google/nfc-smart-tag/docs/FirmwareStack.png

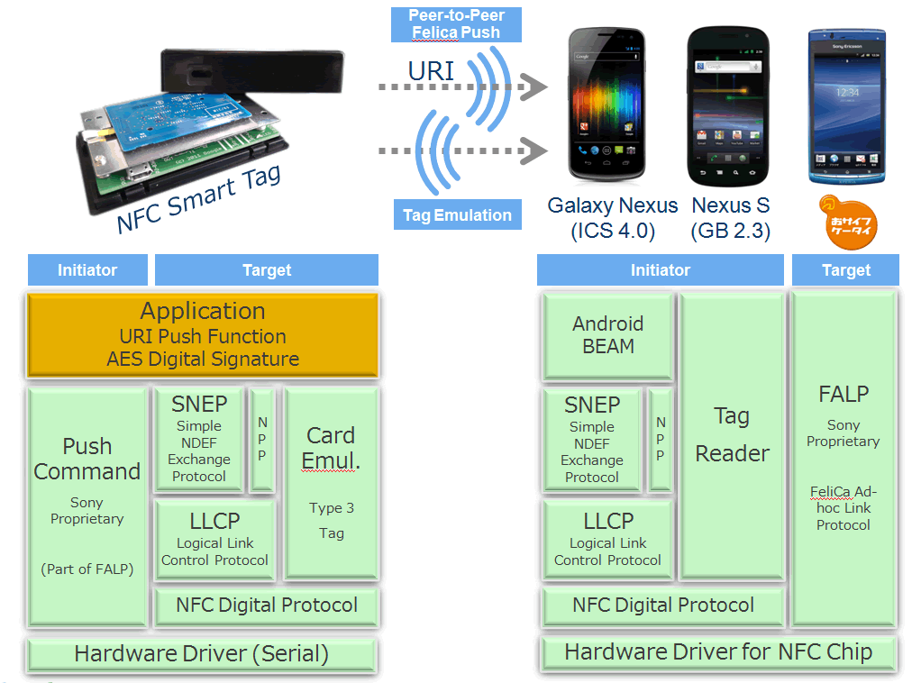
docs/FirmwareStack.png
