google/nfc-smart-tag/docs/lc115n/01_PCB_Front.JPG

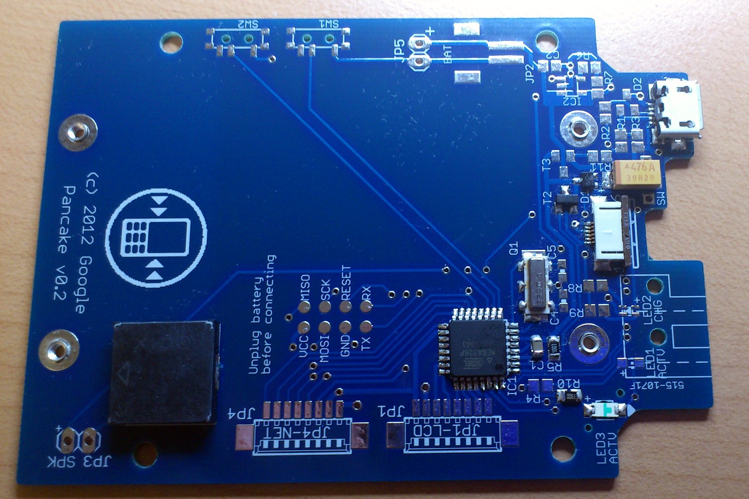
docs/lc115n/01_PCB_Front.JPG
