google/nfc-smart-tag/demoserver/readme.txt

Please download KeyCzar jar file from:
http://code.google.com/p/keyczar/downloads/list

Please download Protobuf source code, and compile it:
http://code.google.com/p/protobuf/downloads/list
