google/nfc-smart-tag/docs/FirmwareModules.png

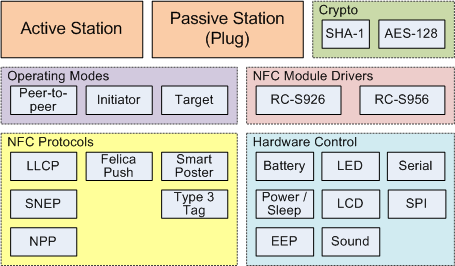
docs/FirmwareModules.png
