google/nfc-smart-tag/docs/lc115n/02_PCB_Back.JPG

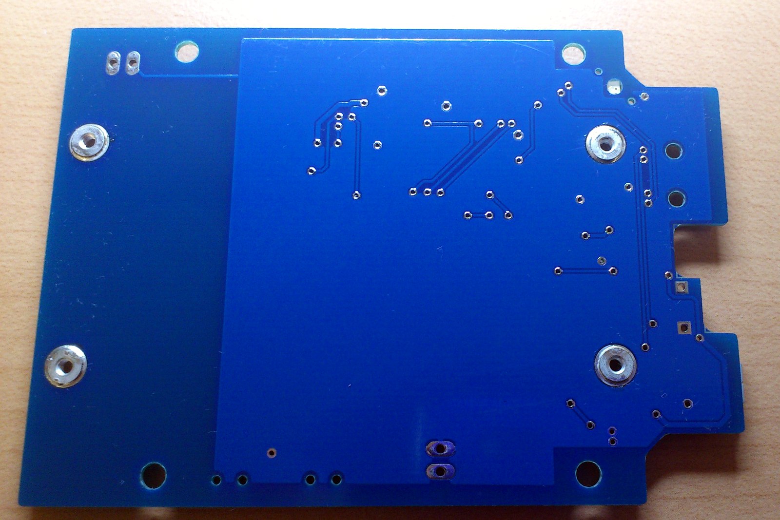
docs/lc115n/02_PCB_Back.JPG
