google/nfc-smart-tag/docs/lc115n/03_Tape.JPG

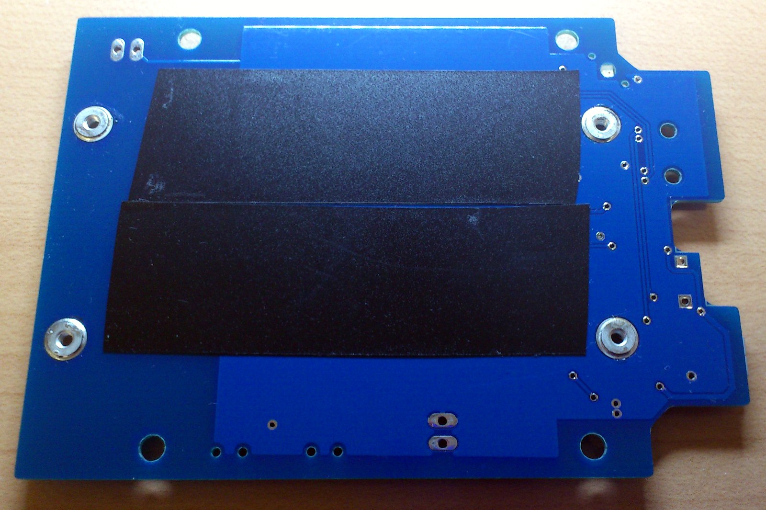
docs/lc115n/03_Tape.JPG
