google/nfc-smart-tag/docs/lc115n/04_RC_S620.JPG

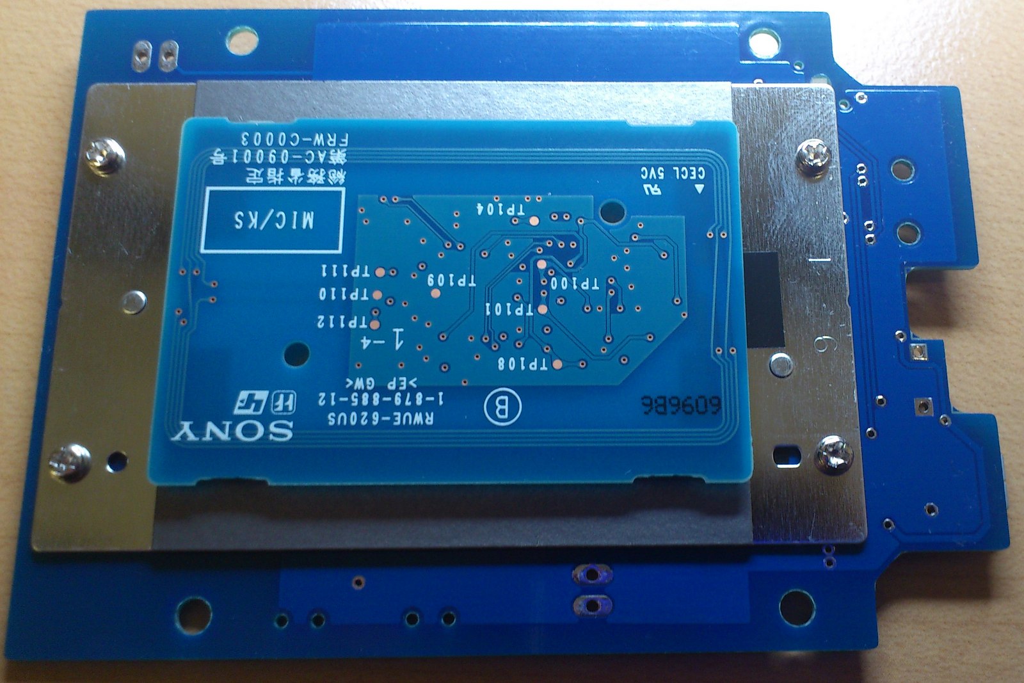
docs/lc115n/04_RC_S620.JPG
