google/nfc-smart-tag/docs/lc115n/05_Cable_Back.JPG

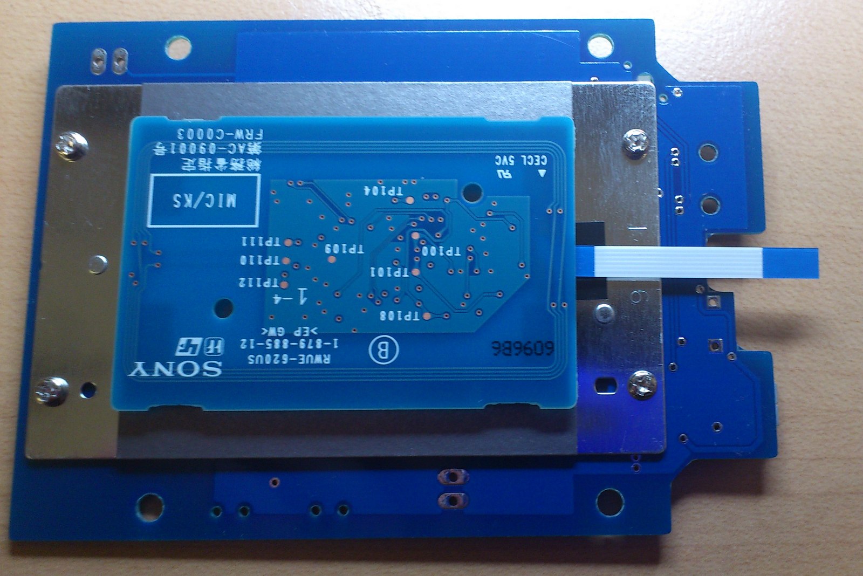
docs/lc115n/05_Cable_Back.JPG
