google/nfc-smart-tag/docs/lc115n/06_Cable_Front.JPG

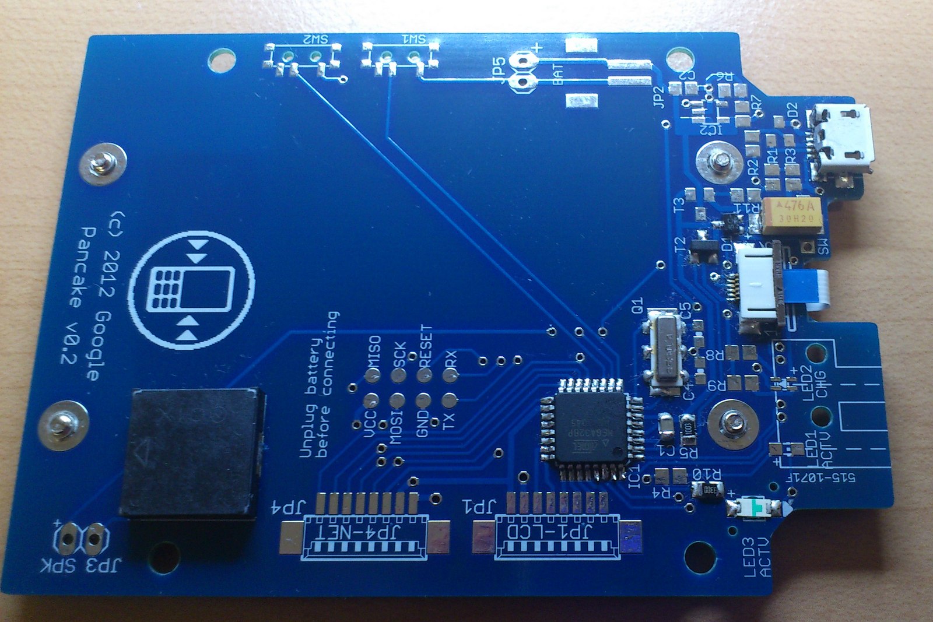
docs/lc115n/06_Cable_Front.JPG
