google/nfc-smart-tag/docs/lc115n/07_Cable_Edge.JPG

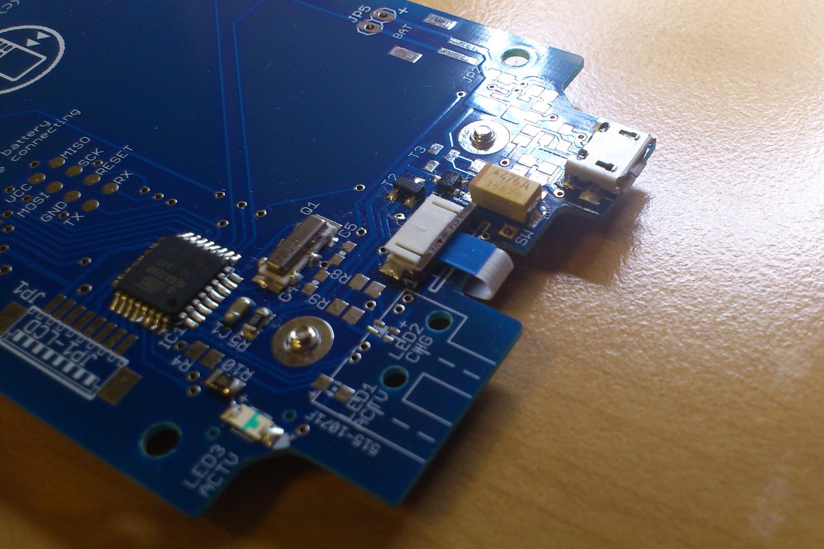
docs/lc115n/07_Cable_Edge.JPG
