google/nfc-smart-tag/docs/lc115n/08_Case_Cover_Inside.JPG

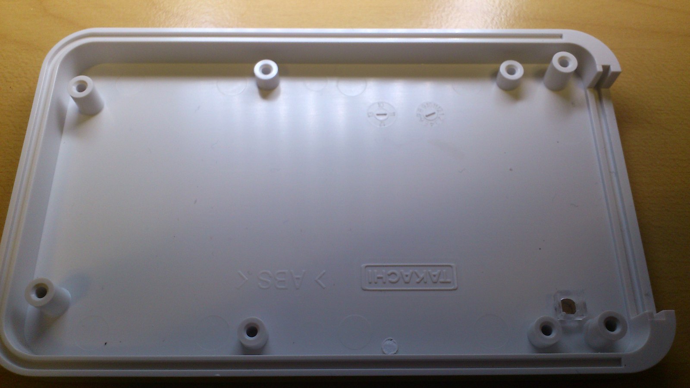
docs/lc115n/08_Case_Cover_Inside.JPG
