google/nfc-smart-tag/docs/lc115n/09_PCB_Case.JPG

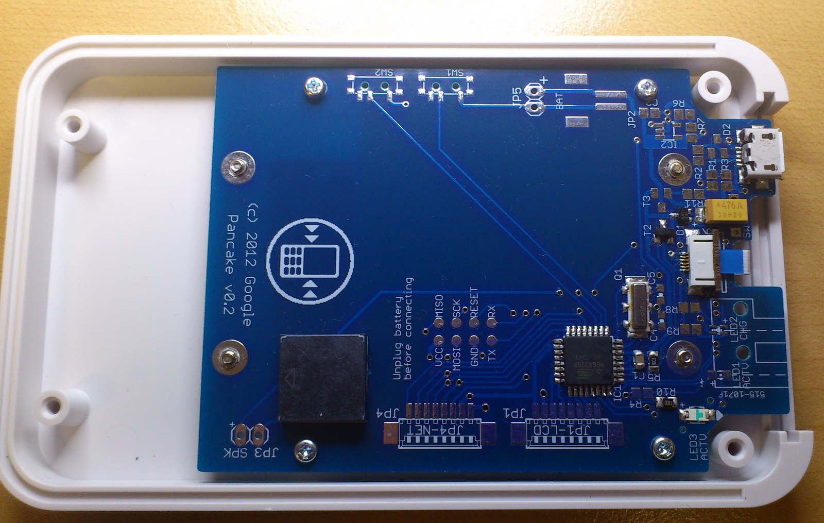
docs/lc115n/09_PCB_Case.JPG
