google/nfc-smart-tag/docs/lc115n/10_Case_Cover_Outside.JPG

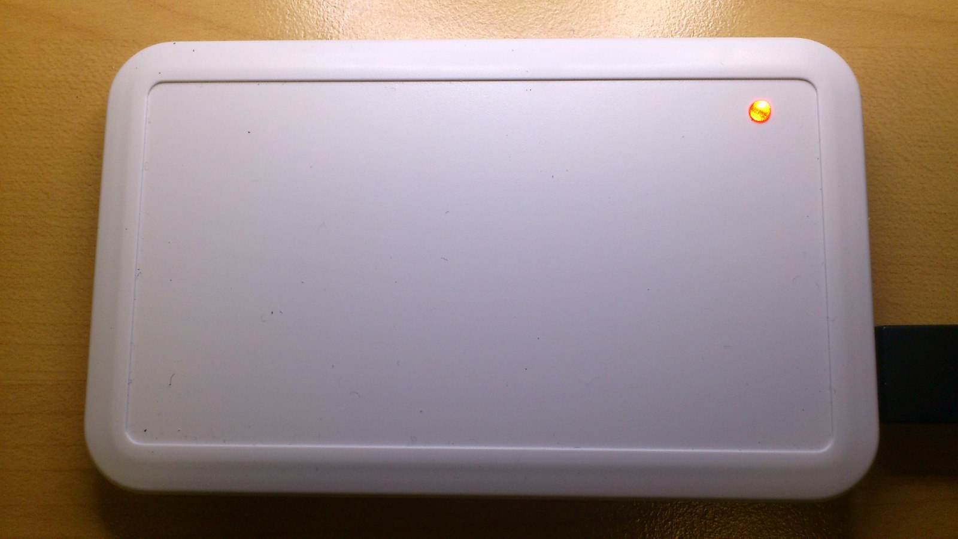
docs/lc115n/10_Case_Cover_Outside.JPG
