google/nfc-smart-tag/docs/lc115n/11_Battery.JPG

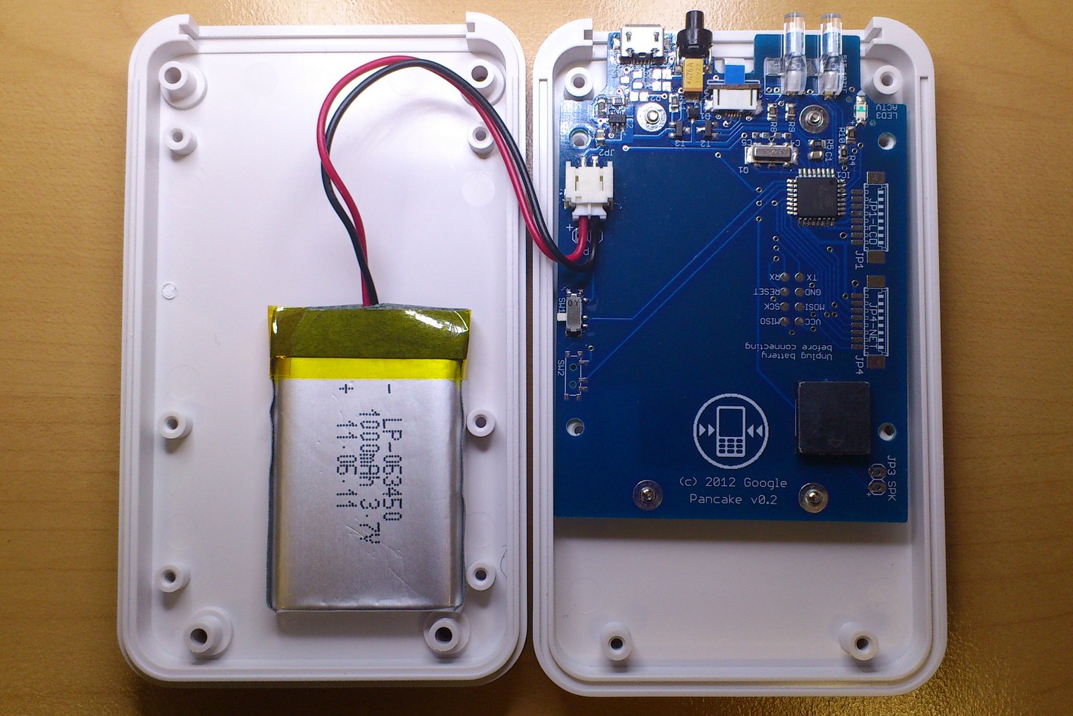
docs/lc115n/11_Battery.JPG
