google/nfc-smart-tag/docs/lc115n/12_Front_Panel_Interior.JPG

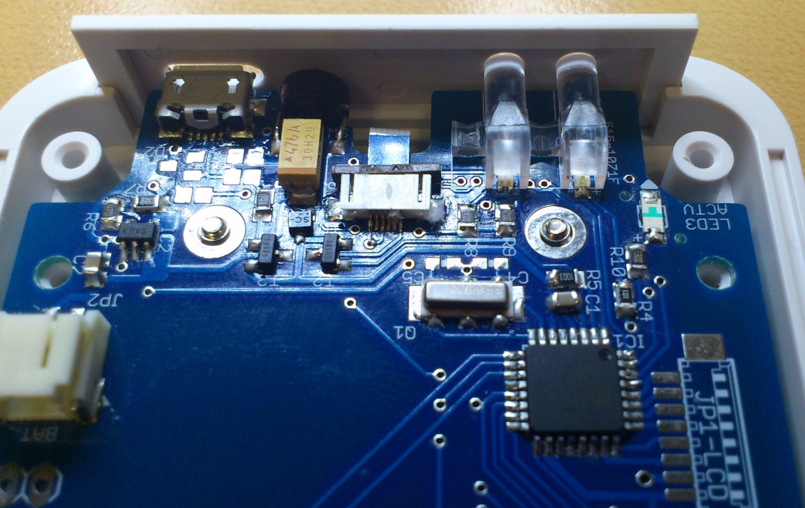
docs/lc115n/12_Front_Panel_Interior.JPG
