google/nfc-smart-tag/docs/lc115n/13_Front_Panel_Exterior.JPG

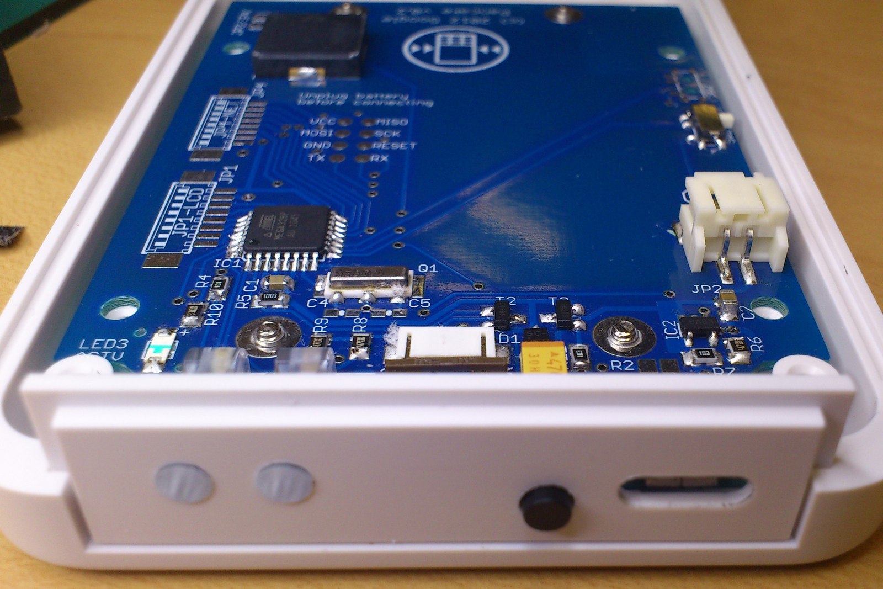
docs/lc115n/13_Front_Panel_Exterior.JPG
