google/nfc-smart-tag/docs/LLCP.png

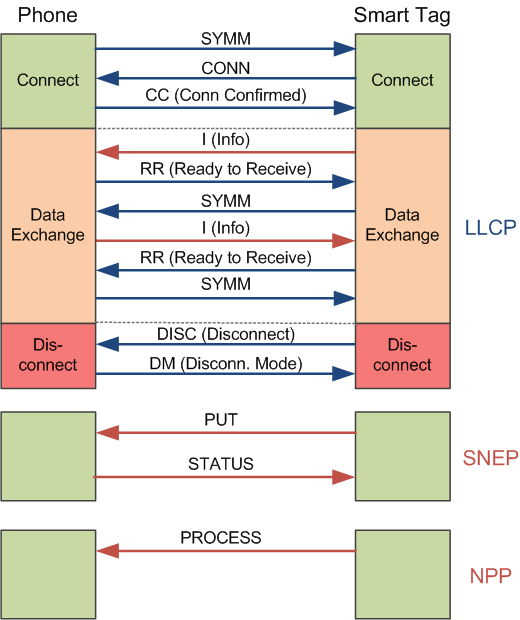
docs/LLCP.png
