google/nfc-smart-tag/docs/NfcUrl2Crypto.png

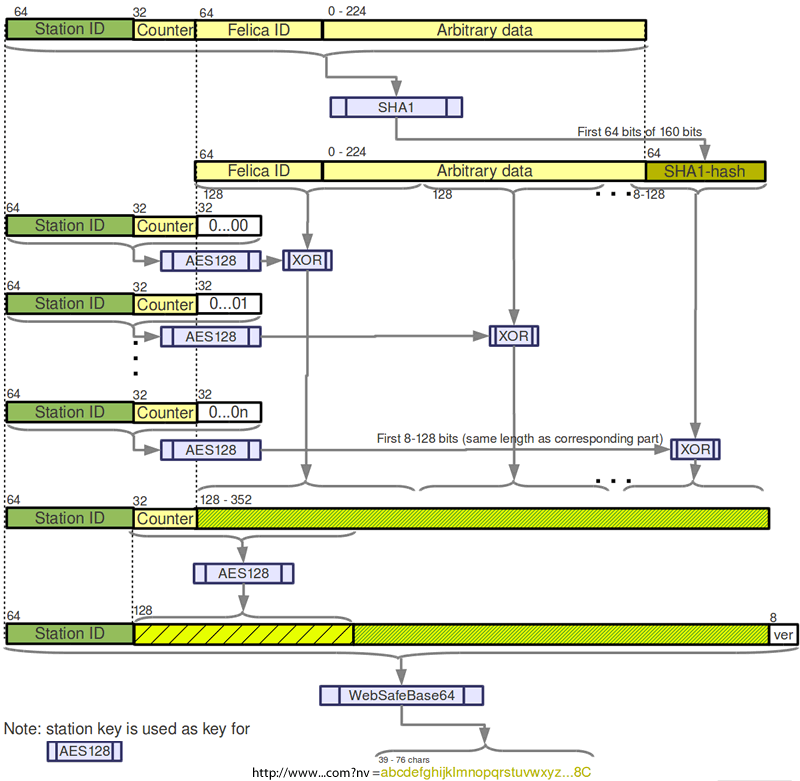
docs/NfcUrl2Crypto.png
