google/nfc-smart-tag/docs/NfcUrl.png

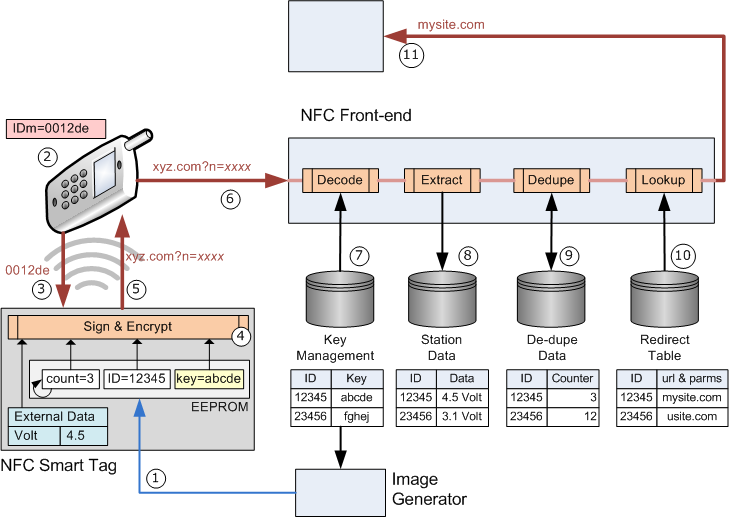
docs/NfcUrl.png
