google/nfc-smart-tag/docs/NfcUrlEncoding.png

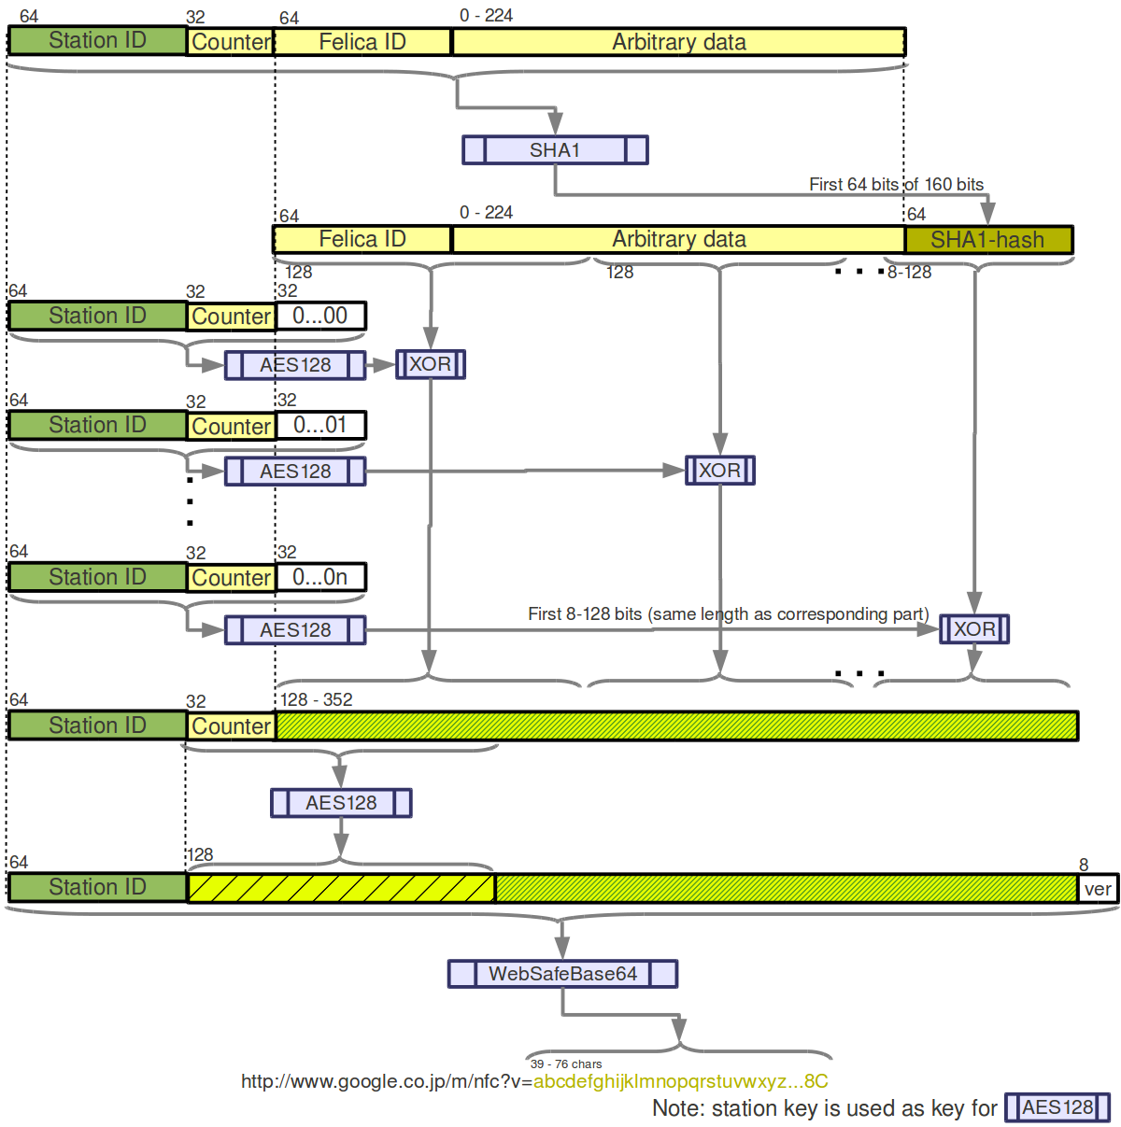
docs/NfcUrlEncoding.png
