google/nfc-smart-tag/hardware/pancake-schematic.png

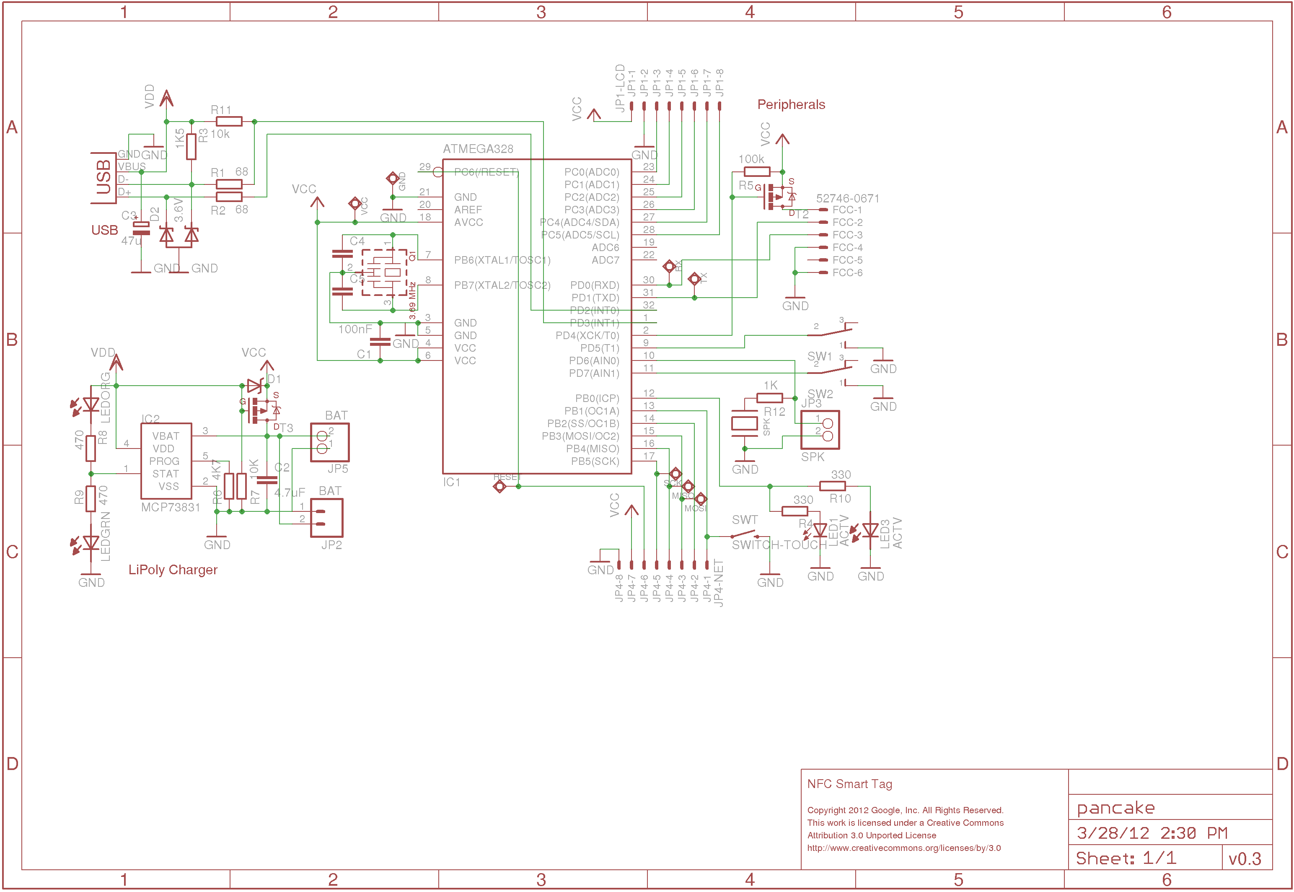
hardware/pancake-schematic.png
