google/nfc-smart-tag/hardware/sandwich-schematic.png

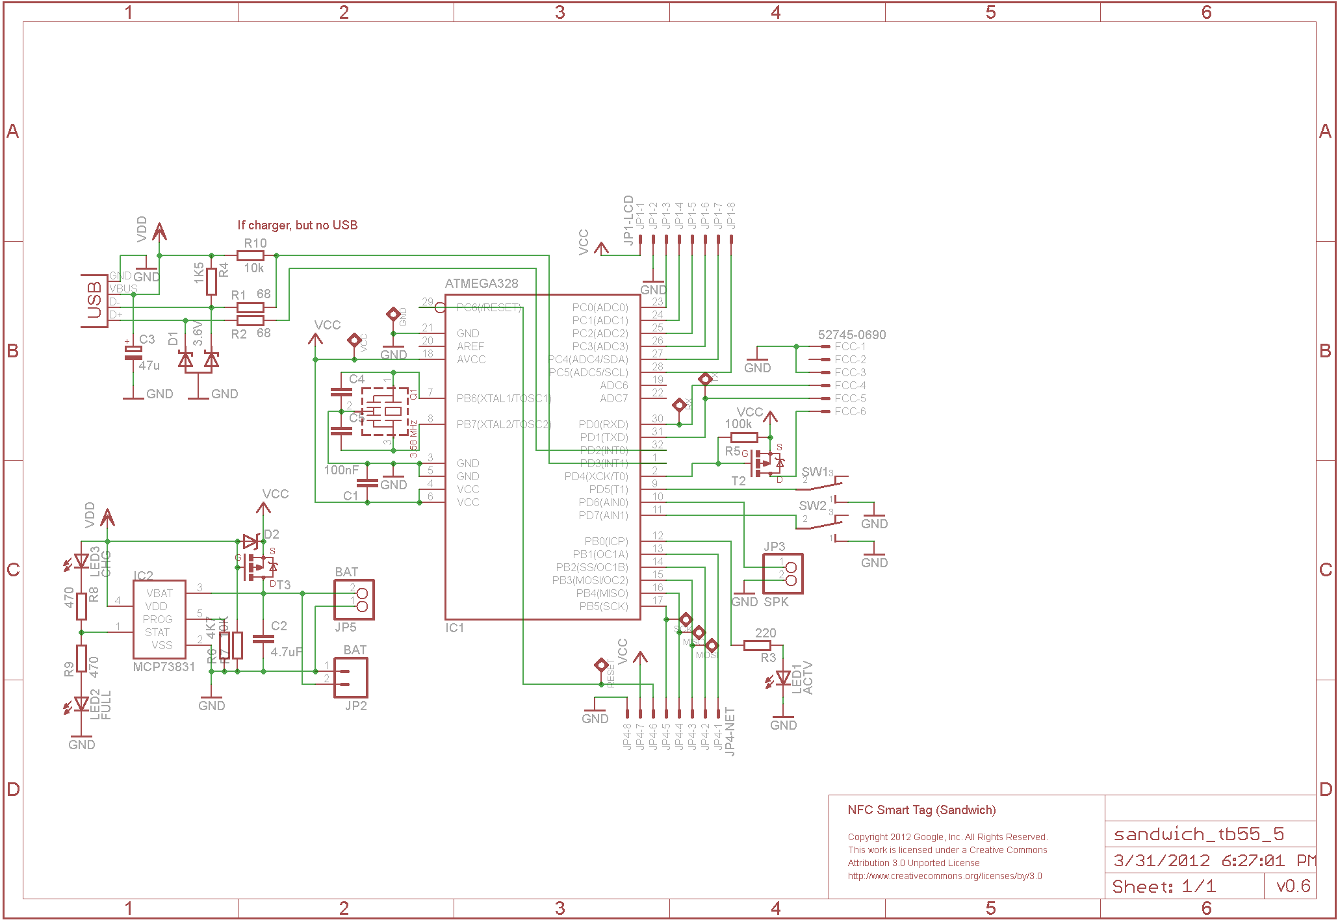
hardware/sandwich-schematic.png
