google/nfc-smart-tag/hardware/NfcSmartTagPartlist.xls

Sheet: Pancake v0.3
Identifier | Quantity | Mfg Part Number | Description | Package | RS Part # | Digikey Part # | Datasheet / Detail
 | 1 | RC-S620/S | Felica R/W Module UART |  |  |  | http://www.sony.co.jp/Products/felica/pdt/rdw9.html
IC1 | 1 | ATMEGA328P-AU | Atmel AVR ATMega 328P | TQFP-32 | 696-3092 | ATMEGA328P-AU-ND | http://akizukidenshi.com/catalog/g/gI-04386/
C1 | 1 | C0805C104K5RAC | Capacitor 0.1 uF | SMD 0805 | 264-4416 | 399-1170-6-ND
Q1 | 1 | CSTCC3M69G53-R0 | Ceramic Oscillator 3.69 MHz 15pF (Murata) | SMD | 624-1005 |  | http://docs-asia.electrocomponents.com/webdocs/0021/0900766b80021b54.pdf
 | 0 | CX8045GB16000H0HEQZ1 | 16.000MHz Quartz | 8.0x4.5mm | 693-6236P |  | http://global.kyocera.com/prdct/electro/pdf/xtal/cx8045gb_cs_e.pdf
C4,C5 | 0 | GRM1885C1H120JA01D | Capacitor 12pF | SMD 0603 | 653-0349 |  | http://jp.rs-online.com/web/p/ceramic-multilayer/6530349/
C3 | 1 | TAJC476K010RNJ | Capacitor 47uF/10V Tantal | SMD 6032 | 464-8000 | 478-3910-1-ND | http://docs-asia.electrocomponents.com/webdocs/0e0c/0900766b80e0c346.pdf
 | 1 | Molex 21020-0051 | FCC Cable 0.5mm pitch 6 pin 30mm |  |  | WM14311-ND | www.molex.com/product/premoflex_ffc-fpc.html
FCC | 1 | Molex 52746-0671 | FCC/FPC Connector 0.5mm pitch 6 pin BOTTOM contact |  | 702-5431 | WM7977CT-ND | http://www.molex.com/molex/products/datasheet.jsp?part=active/0527460671_FFC_FPC_CONNECTORS.xml
USB | 1 | ZX62-B-5PA(11) | Micro USB SMD connector |  | 685-0965 | H11634CT-ND | http://www.hirose.co.jp/cataloge_hp/e24200011.pdf
BATT | 1 | S2B-PH-SM4-TB | JST2 Connector side entry SMT | 2mm | 688-1353 | 455-1749-1-ND | http://www.jst-mfg.com/product/pdf/eng/ePH.pdf
IC2 | 1 | MCP73831T-2ACI/OT | Li Poli Battery charge controller | SOT-23-5 | 669-6137 |  | http://jp.rs-online.com/web/p/battery-management/6696137P/
C2 | 1 | SMT CAP 4.7uF | Capacitor 4.7uF | SMD 0805 | 723-6041
R6 | 1 | CRG0805F4K7 | Charge control resistor 4.7kOhm | SMD 0805 | 223-0528
R7 | 1 | ERJ-6GEYJ103V | Gate pull-down resistor 10kOhm | SMD 0805 |  | P10KACT-ND
LED2 | 1 | SML-521MDWT86 | Dual color LED green / orange | SMD 0605 | 475-2569 | 511-1316-1-ND | http://docs-asia.electrocomponents.com/webdocs/1020/0900766b81020b10.pdf
R8, R9 | 2 | CRG0805F470R | Charge LED Resistor 470Ohm | SMD 0805 | 223-0376
D1 | 1 | AB1003M3-S-TL | Shottky Diode | MCPH-3 | 664-1177 |  | http://docs-asia.electrocomponents.com/webdocs/0d02/0900766b80d023e0.pdf
PIPE1 | 1 | 515-1071F | Dialight Lightpipe Dual 3mm |  | 546-1400 | 350-1590-ND | http://www.dialight.com/Product/Details/445028/5151071F
R11 | 1 | ERJ-6GEYJ103V | Ext. Power sense resistor 10kOhm | SMD 0805 |  | P10KACT-ND
SW | 1 | EVQ-11L07K | Pushbutton 7mm 160gf |  |  | P8080SCT-ND
T2, T3 | 2 | IRLML6402 | P-chan MOSFET 20V 65mOhm | SOT-23 | 301-322 | IRLML6402PBFCT-ND
R5 | 1 | ERJ-6GEYJ104V | Gate pull-down Resistor 100kOhm | SMD 0805 |  | P100KACT-ND
R1, R2 | 2 | CRG0805F68R | Resistor 68Ohm | SMD 0805 | 223-0275 | P68ACT-ND
R3 | 1 | CRG0805F1K5 | Resistor 1.5kOhm | SMD 0805 | 223-0449 | P1.5KACT-ND
D2 | 1 | AZ23C3V6-7-F | Dual Zener Diode 3.6V common anode | SOT 23 | 708-1841 |  | http://docs-asia.electrocomponents.com/webdocs/0e37/0900766b80e37071.pdf
R4 | 1 | ERJ-6GEYJ331V | Resistor 330Ohm 0.125W | SMD 0805 | 434-135 | P330ACT-ND
LED1 | 1 | LTST-C170KRKT | LED red 54mCd ACTV | SMD 0805 | 692-0916 | 160-1415-1-ND | http://docs-asia.electrocomponents.com/webdocs/0dc0/0900766b80dc027b.pdf
R10 |  | ERJ-6GEYJ331V | Resistor 330Ohm 0.125W | SMD 0805 | 434-135 | P330ACT-ND
LED3 | 1 | LTST-C230KFKT | LED Orange 90mCd Reverse | SMD 1206 | 692-1095 | 160-1458-1-ND | http://docs-asia.electrocomponents.com/webdocs/0dc0/0900766b80dc0579.pdf
 | 0 | LTST-C230KGKT | LED Green 35mCd Reverse | SMD 1206 | 692-1105 | 160-1456-1-ND
 | 0 | LTST-C230KRKT | LED Red 54mCd Reverse | SMD 1206 |  | 160-1457-1-ND
PIPE2 | 0 | VLP-250-F | Lightpipe Round 3mm vertical 6mm long (Bivar) |  | 713-4765 | 492-1307-ND | http://docs-asia.electrocomponents.com/webdocs/0e77/0900766b80e77d26.pdf
SPK | 1 | PKLCS1212E2000-R1 | Buzzer Murata | SMT | 619-8456 | 490-5260-1-ND | http://www.murata.com/products/catalog/pdf/p37e.pdf
R12 | 1 | ERJ-6GEYJ102V | Resistor 1kOhm | SMD 0805 | 434-191 | P1.0KATR-ND
JP1, JP4 | 0 | 53261-0871 | Molex Picoblade | SMT | 542-7157 | WM7626CT-ND | http://www.molex.com/customer.html?supplierPN=53261-0871
SW1,SW2 | 2 | CUS-12B | Slide Switch SMT |  | 602-3633 | 563-1102-1-ND | http://docs-asia.electrocomponents.com/webdocs/074f/0900766b8074ff1d.pdf
 | 1 | Takachi LC115-N | Case |  |  |  | http://www.takachi-enclosure.com/data/pdf/English_LCS_LC_0331.pdf
 | 2 | Takachi EM-2.3 | Takachi Case screw |  |  |  | http://www.takachi-el.co.jp/data/bin/price_disp.php?num[]=EM
 | 4 | TH-1.6-M2 | Through Hole Tap |  | MAC8 |  | http://www.mac8sdk.co.jp/mac8/pdf/TH.pdf
 | 4 |  | Screw M2 3mm
 | 1 |  | PCB
 |  |  | Total Cost

Sheet: Sandwich v0.5
Identifier | Quantity | Mfg Part Number | Description | Package | RS Part # | Digikey Part # | Datasheet / Detail
 | 1 | RC-S620/S | Felica R/W Module UART |  |  |  | http://www.sony.co.jp/Products/felica/pdt/rdw9.html
IC1 | 1 | ATMEGA328P-AU | Atmel AVR ATMega 328P | TQFP-32 | 696-3092 | ATMEGA328P-AU-ND | http://akizukidenshi.com/catalog/g/gI-04386/
C1 | 1 | C0805C104K5RAC | Capacitor 0.1 uF | SMD 0805 | 264-4416 | 399-1170-6-ND
Q1 | 1 | CSTCC3M69G53-R0 | Ceramic Oscillator 3.69 MHz 15pF | SMD | 624-1005 |  | http://docs-asia.electrocomponents.com/webdocs/0021/0900766b80021b54.pdf
 | 0 | CX8045GB16000H0HEQZ1 | 16.000MHz Quartz | 8.0x4.5mm | 693-6236P |  | http://global.kyocera.com/prdct/electro/pdf/xtal/cx8045gb_cs_e.pdf
C4,C5 | 0 | GRM1885C1H120JA01D | Capacitor 12pF | SMD 0603 | 653-0349 |  | http://jp.rs-online.com/web/p/ceramic-multilayer/6530349/
C3 | 1 | TAJC476K010RNJ | Capacitor 47uF/10V Tantal | SMD 6032 | 464-8000 | 478-3910-1-ND | http://docs-asia.electrocomponents.com/webdocs/0e0c/0900766b80e0c346.pdf
 | 1 | Molex 21020-0051 | FCC Cable 0.5mm pitch 6 pin 30mm |  |  | WM14311-ND | www.molex.com/product/premoflex_ffc-fpc.html
FCC | 1 | Molex 52745-0697 | FCC/FPC Connector 0.5mm pitch 6 pin TOP contact |  | 542-6817 | WM7972CT-ND | www.molex.com/product/premoflex_ffc-fpc.html
USB | 1 | ZX62-B-5PA(11) | Micro USB SMD connector |  | 685-0965 | H11634CT-ND | http://www.hirose.co.jp/cataloge_hp/e24200011.pdf
BATT | 1 | S2B-PH-SM4-TB | JST2 Connector side entry SMT | 2mm | 688-1353 | 455-1749-1-ND | http://www.jst-mfg.com/product/pdf/eng/ePH.pdf
IC2 | 1 | MCP73831T-2ACI/OT | Li Poli Battery charge controller | SOT-23-5 | 669-6137 |  | http://jp.rs-online.com/web/p/battery-management/6696137P/
C2 | 1 | SMT CAP 4.7uF | Capacitor 4.7uF | SMD 0805 | 723-6041
R6 | 1 | CRG0805F4K7 | Charge control resistor 4.7kOhm | SMD 0805 | 223-0528
R7 | 1 | CRG0805F10K | Gate pull-down resistor 10kOhm | SMD 0805 | 223-0562
LED2 | 1 | LTST-S220AKT | LED side view orange 4mCd (CHG) | SMD 0805 | 692-1170 |  | http://docs-asia.electrocomponents.com/webdocs/0dc0/0900766b80dc0b69.pdf
LED3 | 1 | LTST-S110KGKT | LED side view green (FULL) | SMD 0805 | 692-1180 |  | http://jp.rs-online.com/web/p/visible-led/6921180/
R8, R9 | 2 | CRG0805F330R | Charge LED Resistor 330Ohm | SMD 0805 | 223-0354
D1 | 1 | AB1003M3-S-TL | Shottky Diode | MCPH-3 | 664-1177 |  | http://docs-asia.electrocomponents.com/webdocs/0d02/0900766b80d023e0.pdf
T2, T3 | 2 | IRLML6402 | P-chan MOSFET 20V 65mOhm | SOT-23 | 301-322 | IRLML6402PBFCT-ND | http://docs-asia.electrocomponents.com/webdocs/0afc/0900766b80afc1ef.pdf
R5 | 1 | CRG0805F100K | Gate pull-down Resistor 100kOhm | SMD 0805 | 223-0691
T1 | 1 | MMUN2214LT1G | Digital Transistor 10k/47k | SOT-23 | 463-195 |  | http://docs-asia.electrocomponents.com/webdocs/0b36/0900766b80b36087.pdf
 | 2 | CRG0805F68R | Resistor 68Ohm | SMD 0805 | 223-0275
 | 1 | CRG0805F1K5 | Resistor 1.5kOhm | SMD 0805 | 223-0449
 | 1 | AZ23C3V6-7-F | Dual Zener Diode 3.6V common anode | SOT 23 | 708-1841 |  | http://docs-asia.electrocomponents.com/webdocs/0e37/0900766b80e37071.pdf
R3 | 1 | CRG0805F220R | Resistor 220Ohm 0.125W | SMD 0805 | 223-0332
LED1 | 1 | LTST-S220KRKT | LED side view red 54mCd (ACTV) | SMD 0805 | 692-1199 |  | http://jp.rs-online.com/web/p/visible-led/6921199/
BUZ | 1 | PKM17EWH4000 | Buzzer Murata | Lead type | 498-2596 | 490-4696-ND | http://www.murata.com/products/catalog/pdf/p37e.pdf
 | 0 | 53261-0871 | Molex Picoblade | SMT | 542-7157 | WM7626CT-ND | http://www.molex.com/customer.html?supplierPN=53261-0871
SW1,SW2 | 2 | CUS-12B | Slide Switch SMT |  | 602-3633 | 563-1102-1-ND | http://docs-asia.electrocomponents.com/webdocs/074f/0900766b8074ff1d.pdf
 | 1 | Teishin TB-55 | Case |  | 605-8881 |  | http://www.teishin-bel.co.jp/mokuji_case/newpagecase.html
 | 2 | Takachi EM-3 | Takachi Case screw |  |  |  | http://www.takachi-el.co.jp/data/bin/price_disp.php?num[]=EM
 | 2 | THF-1.6-5.0-M2 | Threaded Stud 5mm |  | MAC8 |  | http://www.mac8sdk.co.jp/mac8/parts/TTT/thf.html
 | 2 |  | Screw M2 4mm
 | 1 |  | PCB
 |  |  | Total Cost
