google/nfc-smart-tag/(commit log)

2012-03-09 Added EAGLE files for Pancake
    [pancake.brd, pancake.sch]
2012-03-16 EAGLE files for sandwich
    [sandwich_tb55_5.brd, sandwich_tb55_5.sch]
2012-03-21 added clock precision timer and compensated for interrupt delay
2012-03-22 Photos of mounting pancake inside LC115-N case
2012-03-23 Renamed module power control methods
2012-03-23 Added part list
    [NfcSmartTagPartlist.xls]
2012-03-23 Removed digitrans compiler switch
2012-03-25 Added support for felica plug. Still needs main. Should be converted to be interrupt driven to minimize power consumption
2012-03-26 Initial working version of Felica Plug. Needs a lot of tuning for power consumption and dynamic creation of URL.
2012-03-26 Include plug in all target. Print size for each hex file
2012-03-26 Sleep in lower power mode until rf field detected. Renamed methods to Rcs926, which is the controller chip name
2012-03-27 Sleep plug after power on melody
2012-03-27 Optimized Plug version for low power consumption
2012-03-27 Renamed rcs801 to rcs926 Fixed strcpy/mempcy bug
    [station_rcs926.c]
2012-03-28 Pancake v0.3 Design: - Creative Commons License - Larger thermal pad for charger - Protective resistor for buzzer - Touch switch in schematic and pcb - Vias covered with stop mask
    [pancake.brd, pancake.sch]
2012-03-28 Corrected orientation marker on buzzer Added 5mm pitch push switch Added Creative Commons logo
2012-03-28 Added R12 for Snadwich v0.3
    [NfcSmartTagPartlist.xls]
2012-03-29 Fixed method name for target mdoe (not yet supported)
    [station_rcs956.c]
2012-03-29 Return error if excessive number of blocks requested
    [station_rcs926.c]
2012-03-31 Added R10 to Sandwich board Removed Digitrans to be consistent with Pancake Cleaned up labels and routing Added copyright notice to schematic
    [sandwich_tb55_5.brd, sandwich_tb55_5.sch]
2012-03-31 Added PNG schematic for Sandwich
2012-04-19 Move reset on power source change up before sleeping on low power. Wake up NFC module if in target mode.
    [station_rcs956.c]
